amalnathkp13-boop/EquiSense-ForcePlatform/firmware/README.md

# Firmware

ESP32 dual-core firmware (HX711 quad driver, Butterworth filter, CoP and posturography metrics). Scheduled for Month 2 (Dec 2026); see docs/PROJECT_HANDOVER.md, Section 6.
