amalnathkp13-boop/EquiSense-ForcePlatform/hardware/cad/renders/cad_exploded.png

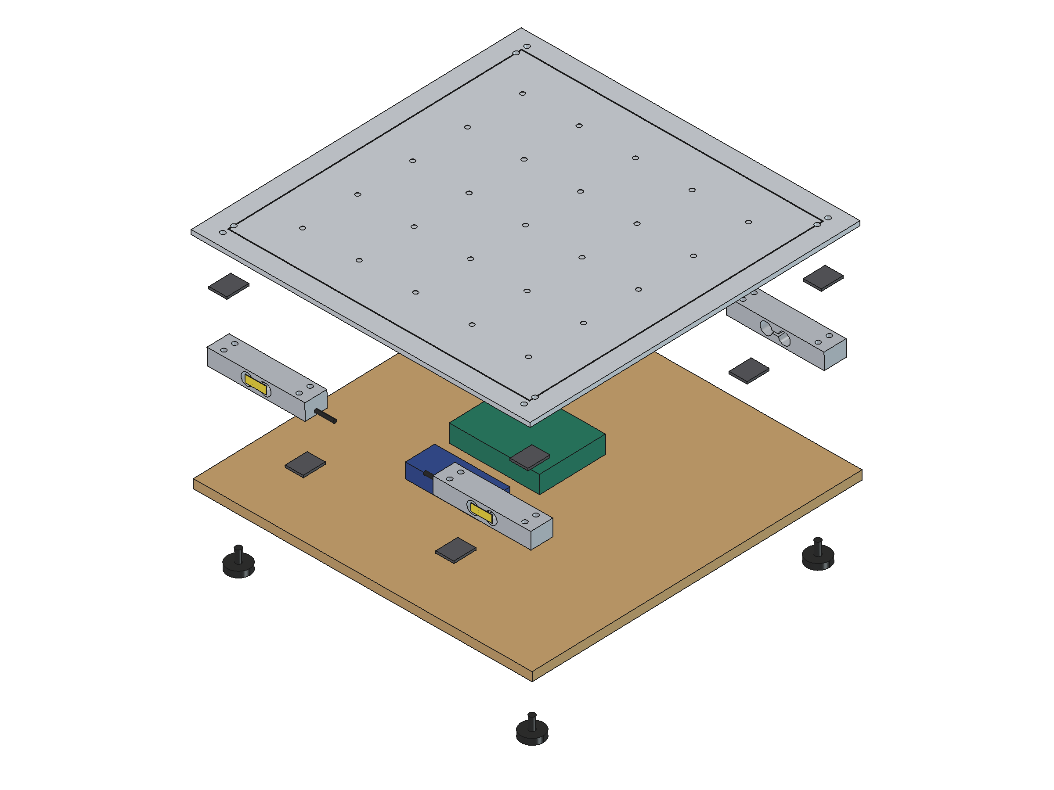
hardware/cad/renders/cad_exploded.png
