amalnathkp13-boop/EquiSense-ForcePlatform/hardware/cad/renders/cad_iso.png

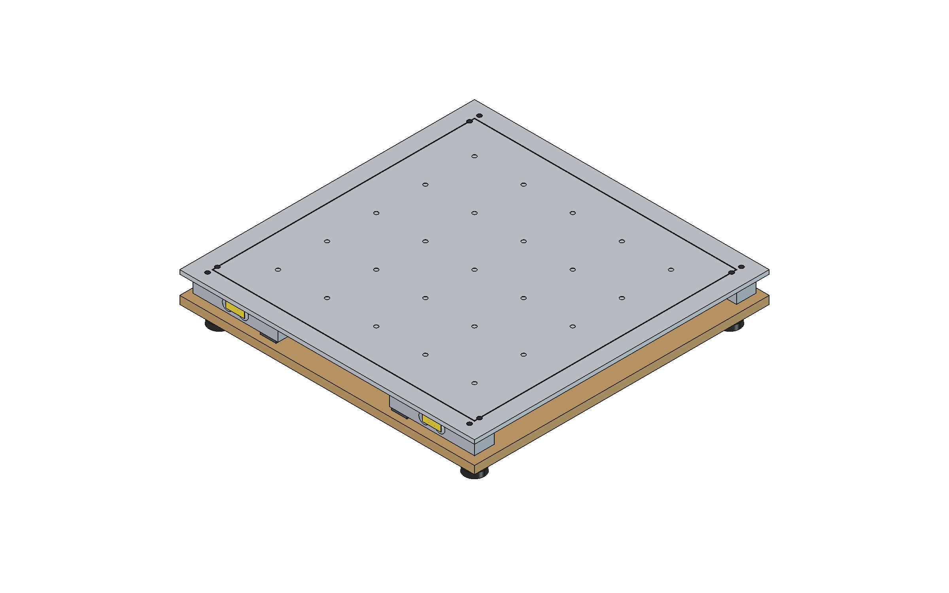
hardware/cad/renders/cad_iso.png
