amalnathkp13-boop/EquiSense-ForcePlatform/hardware/cad/renders/cad_top_xray.png

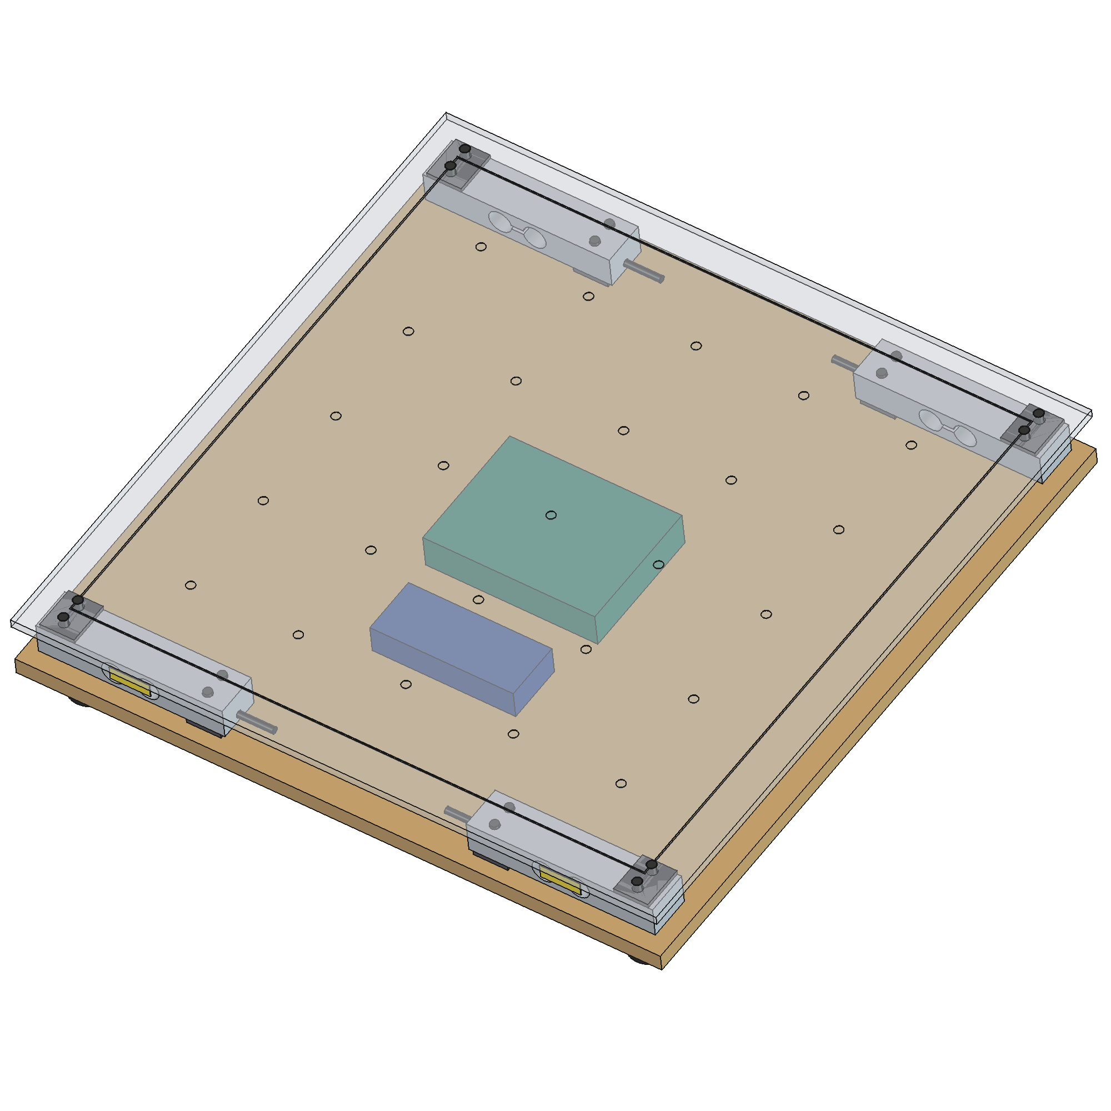
hardware/cad/renders/cad_top_xray.png
