amalnathkp13-boop/EquiSense-ForcePlatform/hardware/cad/renders/fea_vonmises.png

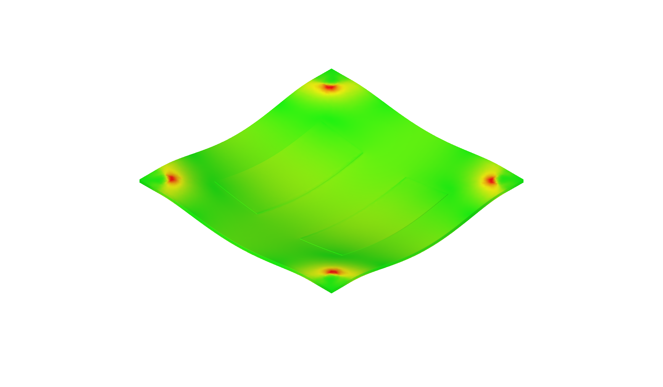
hardware/cad/renders/fea_vonmises.png
