amalnathkp13-boop/EquiSense-ForcePlatform/hardware/kicad/export/EquiSense_BOM.csv

Refs | Value | Footprint | Qty | DNP
C1 | 10uF |  | 1
C2 | 22uF |  | 1
C3 | 1uF |  | 1
C4 | 100nF |  | 1
C10 | 10uF |  | 1
C11 | 100nF |  | 1
C12 | 10uF |  | 1
C13 | 100nF |  | 1
C14 | 10uF |  | 1
C15 | 100nF |  | 1
C16 | 10uF |  | 1
C17 | 100nF |  | 1
D1 | 1N4007 |  | 1
D2 | STATUS |  | 1
J1 | LoadCell_FL |  | 1
J2 | LoadCell_FR |  | 1
J3 | LoadCell_BL |  | 1
J4 | LoadCell_BR |  | 1
J5 | 18650 Shield V8 5V OUT |  | 1
J6 | USB-UART |  | 1
JP1 | HAPTIC_ISOLATE |  | 1
M1 | ERM 10mm 3V |  | 1
Q1 | S8550 |  | 1
Q2 | S8550 |  | 1
Q3 | S8550 |  | 1
Q4 | S8550 |  | 1
Q5 | AO3400A | Package_TO_SOT_SMD:SOT-23 | 1
R1 | 10k |  | 1
R2 | 10k |  | 1
R3 | 1k |  | 1
R4 | 220R |  | 1
R5 | 100k |  | 1
R10 | 20k |  | 1
R11 | 8.2k |  | 1
R12 | 20k |  | 1
R13 | 8.2k |  | 1
R14 | 20k |  | 1
R15 | 8.2k |  | 1
R16 | 20k |  | 1
R17 | 8.2k |  | 1
U1 | ESP32-WROOM-32 | RF_Module:ESP32-WROOM-32 | 1
U2 | AMS1117-3.3 |  | 1
U3 | HX711 | Package_SO:SOIC-16_3.9x9.9mm_P1.27mm | 1
U4 | HX711 | Package_SO:SOIC-16_3.9x9.9mm_P1.27mm | 1
U5 | HX711 | Package_SO:SOIC-16_3.9x9.9mm_P1.27mm | 1
U6 | HX711 | Package_SO:SOIC-16_3.9x9.9mm_P1.27mm | 1
