amalnathkp13-boop/EquiSense-ForcePlatform/hardware/cad/EquiSense_ForcePlatform.step

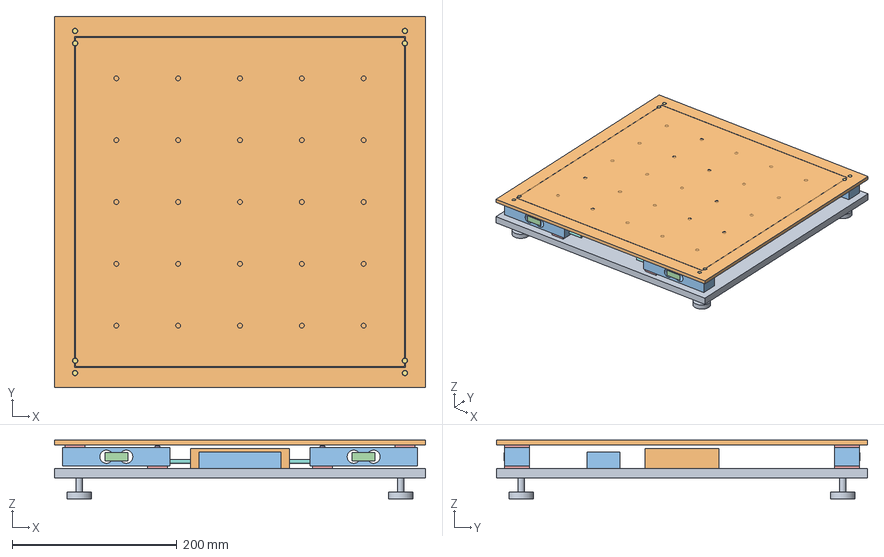
[picture p14: CAD file, 2026-10-14]
hardware/cad/EquiSense_ForcePlatform.step
450.0 x 450.0 x 71.0 mm
