amalnathkp13-boop/EquiSense-ForcePlatform/(list of files, cad)

Other CAD files:
hardware/cad/EquiSense_ForcePlatform.FCStd
