amalnathkp13-boop/EquiSense-ForcePlatform/hardware/kicad/export/EquiSense_schematic.pdf

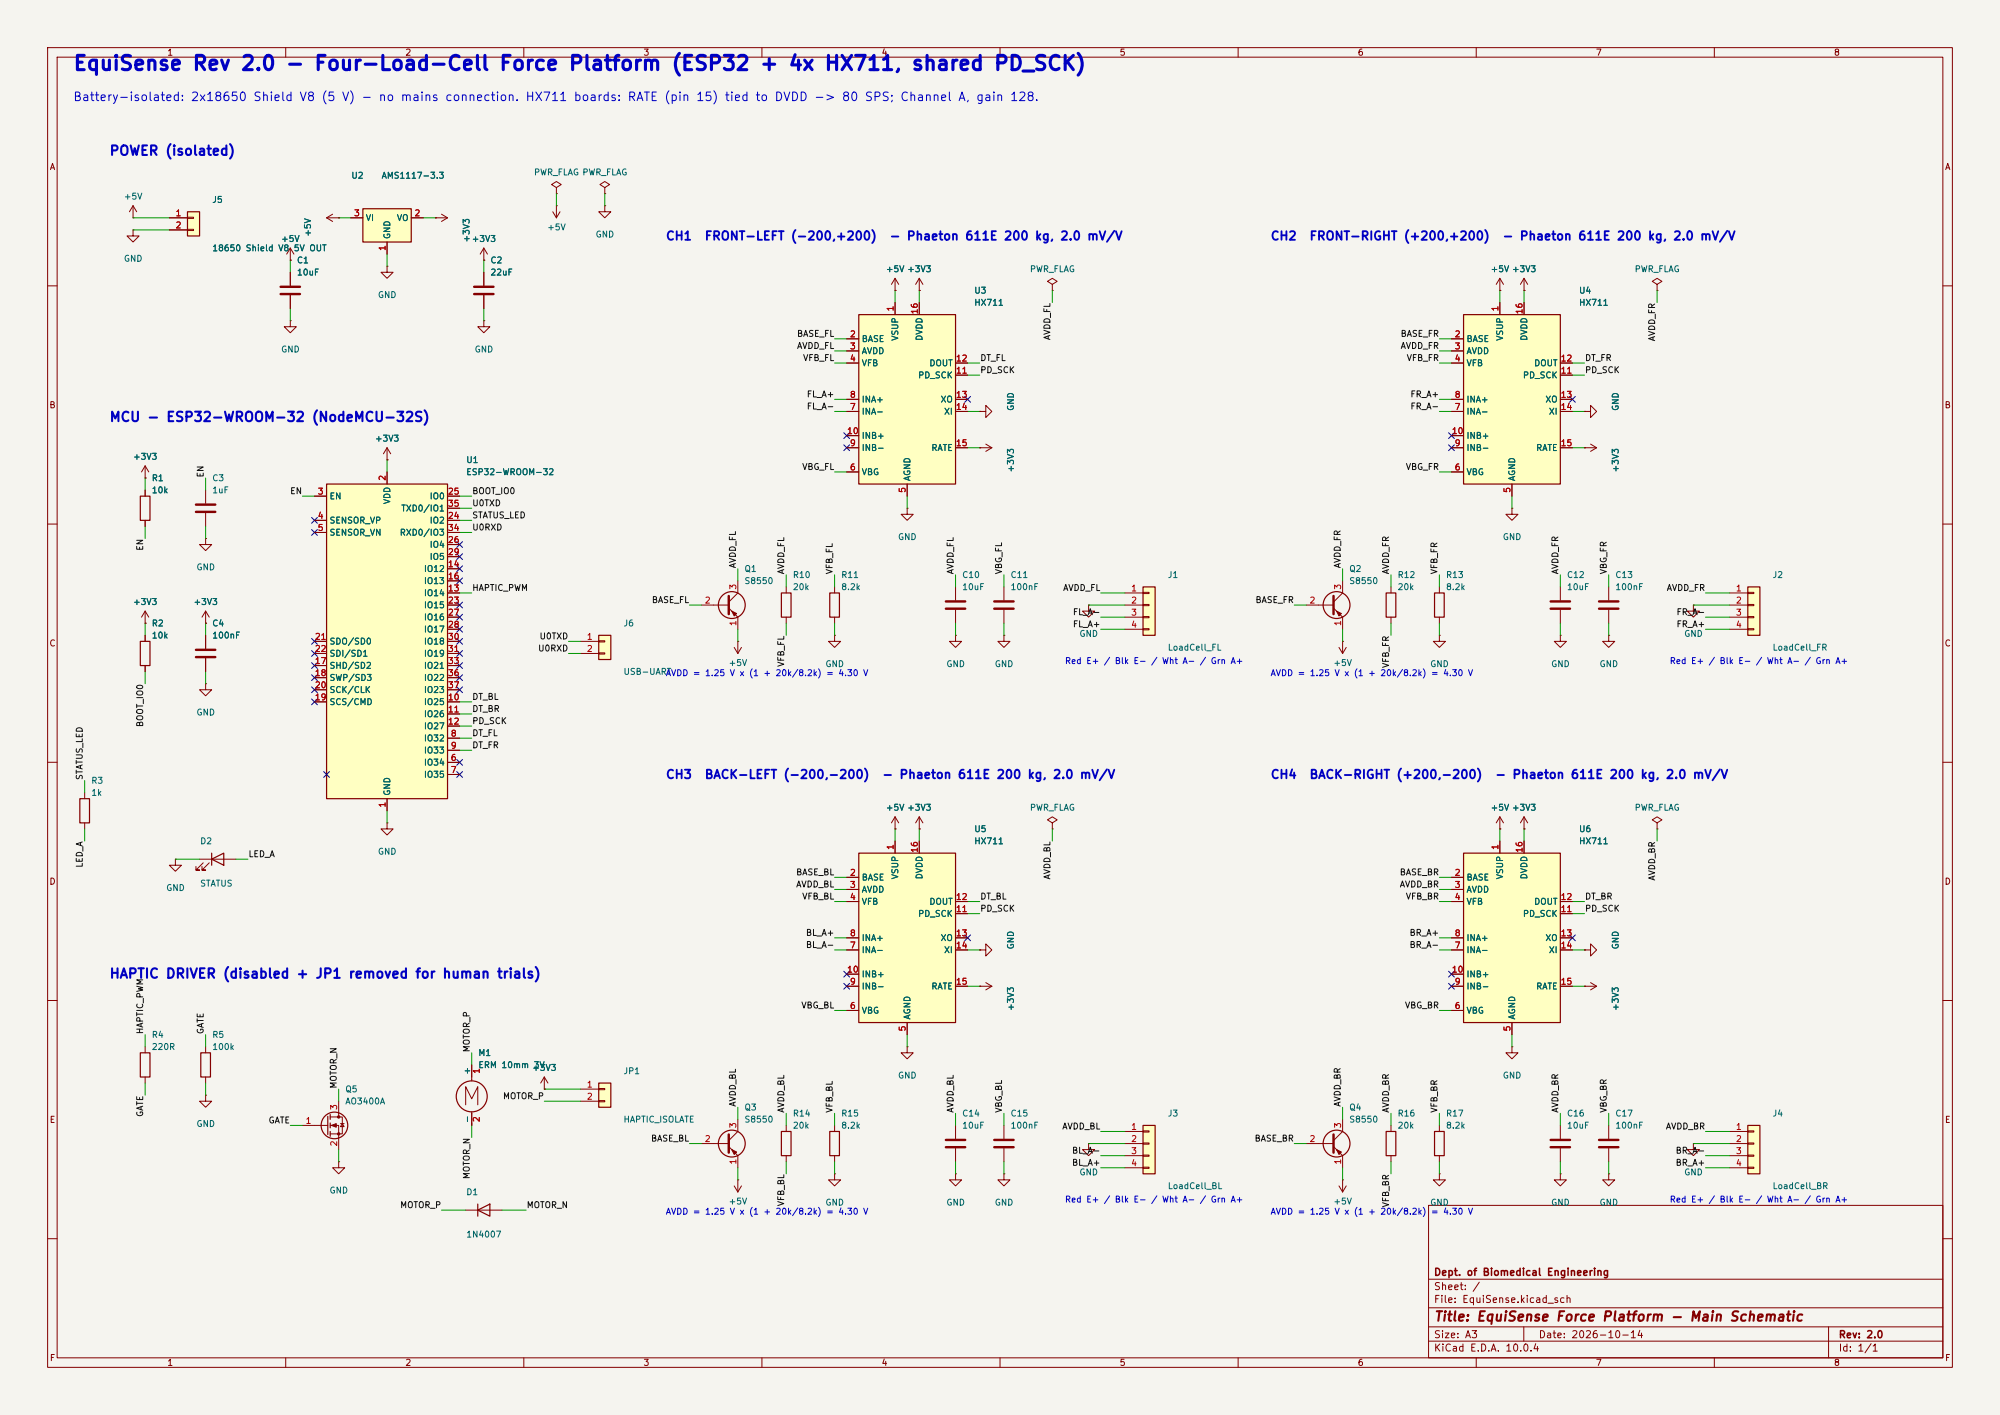
[picture p15: page 1]

EquiSense Rev 2.0 - Four-Load-Cell Force Platform (ESP32 + 4x HX711, shared PD_SCK)

AVDD = 1.25 V x (1 + 20k/8.2k) = 4.30 V Battery-isolated: 2x18650 Shield V8 (5 V) - no mains connection. HX711 boards: RATE (pin 15) tied to DVDD -> 80 SPS; Channel A, gain 128.

Red E+ / Blk E- / Wht A- / Grn A+ CH1 FRONT-LEFT (-200,+200) - Phaeton 611E 200 kg, 2.0 mV/V

AVDD = 1.25 V x (1 + 20k/8.2k) = 4.30 V CH2 FRONT-RIGHT (+200,+200) - Phaeton 611E 200 kg, 2.0 mV/V

Red E+ / Blk E- / Wht A- / Grn A+

Red E+ / Blk E- / Wht A- / Grn A+ CH3 BACK-LEFT (-200,-200) - Phaeton 611E 200 kg, 2.0 mV/V

HAPTIC DRIVER (disabled + JP1 removed for human trials)

Dept. of Biomedical Engineering
Sheet: /
File: EquiSense.kicad_sch
Title: EquiSense Force Platform - Main Schematic

Size: A3 | Rev: 2.0 | F Date: 2026-10-14
KiCad E.D.A. 10.0.4 | Id: 1/1
