amalnathkp13-boop/EquiSense-ForcePlatform/hardware/kicad/EquiSense.kicad_sch

## KiCad design hardware/kicad/EquiSense.kicad_sch (2026-10-14)

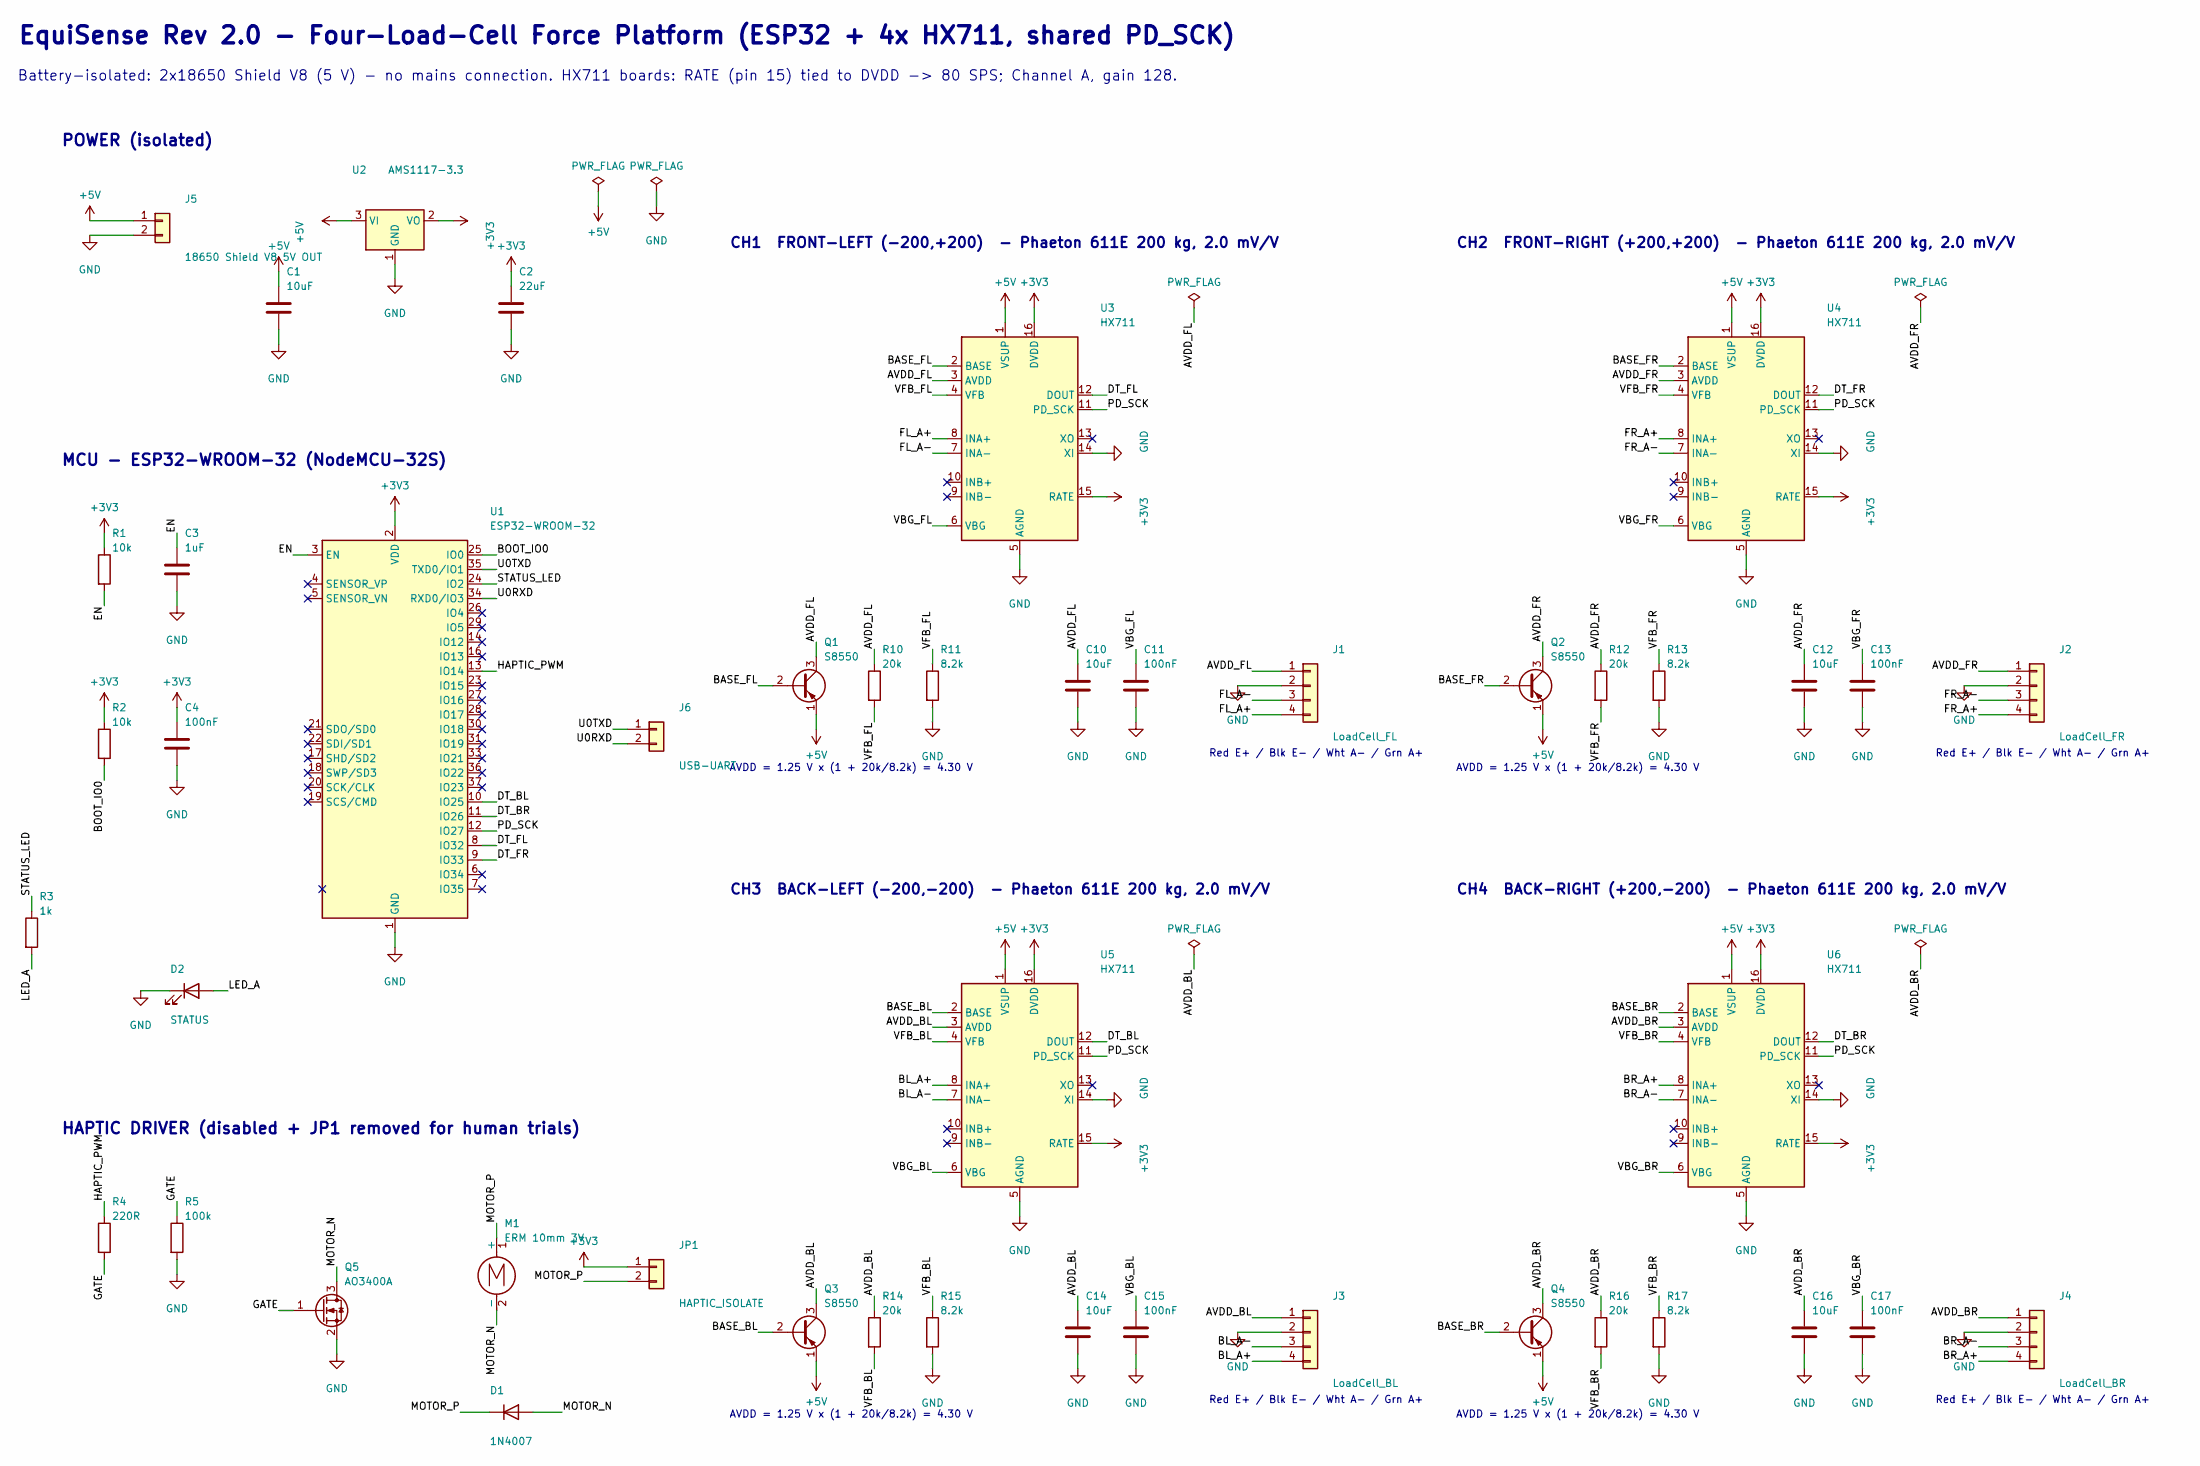
[picture p16: schematic EquiSense.kicad_sch]

Parts:
C1, C10, C12, C14, C16: 10uF
C2: 22uF
C3: 1uF
C4, C11, C13, C15, C17: 100nF
D1: 1N4007
D2: STATUS
J1: LoadCell_FL
J2: LoadCell_FR
J3: LoadCell_BL
J4: LoadCell_BR
J5: 18650 Shield V8 5V OUT
J6: USB-UART
JP1: HAPTIC_ISOLATE
M1: ERM 10mm 3V
Q1, Q2, Q3, Q4: S8550
Q5: AO3400A; SOT-23
R1, R2: 10k
R3: 1k
R4: 220R
R5: 100k
R10, R12, R14, R16: 20k
R11, R13, R15, R17: 8.2k
U1: ESP32-WROOM-32
U2: AMS1117-3.3
U3, U4, U5, U6: HX711; SOIC-16_3.9x9.9mm_P1.27mm

Connections:
+3V3: C2.1, C4.1, JP1.1, R1.1, R2.1, U1.2 (VDD), U2.2 (VO), U3.15 (RATE), U3.16 (DVDD), U4.15 (RATE), U4.16 (DVDD), U5.15 (RATE), U5.16 (DVDD), U6.15 (RATE), U6.16 (DVDD)
+5V: C1.1, J5.1, Q1.1 (E), Q2.1 (E), Q3.1 (E), Q4.1 (E), U2.3 (VI), U3.1 (VSUP), U4.1 (VSUP), U5.1 (VSUP), U6.1 (VSUP)
AVDD_BL: C14.1, J3.1, Q3.3 (C), R14.1, U5.3 (AVDD)
AVDD_BR: C16.1, J4.1, Q4.3 (C), R16.1, U6.3 (AVDD)
AVDD_FL: C10.1, J1.1, Q1.3 (C), R10.1, U3.3 (AVDD)
AVDD_FR: C12.1, J2.1, Q2.3 (C), R12.1, U4.3 (AVDD)
BASE_BL: Q3.2 (B), U5.2 (BASE)
BASE_BR: Q4.2 (B), U6.2 (BASE)
BASE_FL: Q1.2 (B), U3.2 (BASE)
BASE_FR: Q2.2 (B), U4.2 (BASE)
BL_A+: J3.4, U5.8 (INA+)
BL_A-: J3.3, U5.7 (INA-)
BOOT_IO0: R2.2, U1.25 (IO0)
BR_A+: J4.4, U6.8 (INA+)
BR_A-: J4.3, U6.7 (INA-)
DT_BL: U1.10 (IO25), U5.12 (DOUT)
DT_BR: U1.11 (IO26), U6.12 (DOUT)
DT_FL: U1.8 (IO32), U3.12 (DOUT)
DT_FR: U1.9 (IO33), U4.12 (DOUT)
EN: C3.1, R1.2, U1.3 (EN)
FL_A+: J1.4, U3.8 (INA+)
FL_A-: J1.3, U3.7 (INA-)
FR_A+: J2.4, U4.8 (INA+)
FR_A-: J2.3, U4.7 (INA-)
GATE: Q5.1 (G), R4.2, R5.1
GND: C1.2, C2.2, C3.2, C4.2, C10.2, C11.2, C12.2, C13.2, C14.2, C15.2, C16.2, C17.2, D2.1 (K), J1.2, J2.2, J3.2, J4.2, J5.2, Q5.2 (S), R5.2, R11.2, R13.2, R15.2, R17.2, U1.1 (GND), U1.15 (GND), U1.38 (GND), U1.39 (GND), U2.1 (GND), U3.5 (AGND), U3.14 (XI), U4.5 (AGND), U4.14 (XI), U5.5 (AGND), U5.14 (XI), U6.5 (AGND), U6.14 (XI)
HAPTIC_PWM: R4.1, U1.13 (IO14)
LED_A: D2.2 (A), R3.2
MOTOR_N: D1.2 (A), M1.2 (-), Q5.3 (D)
MOTOR_P: D1.1 (K), JP1.2, M1.1 (+)
PD_SCK: U1.12 (IO27), U3.11 (PD_SCK), U4.11 (PD_SCK), U5.11 (PD_SCK), U6.11 (PD_SCK)
STATUS_LED: R3.1, U1.24 (IO2)
U0RXD: J6.2, U1.34 (RXD0/IO3)
U0TXD: J6.1, U1.35 (TXD0/IO1)
VBG_BL: C15.1, U5.6 (VBG)
VBG_BR: C17.1, U6.6 (VBG)
VBG_FL: C11.1, U3.6 (VBG)
VBG_FR: C13.1, U4.6 (VBG)
VFB_BL: R14.2, R15.1, U5.4 (VFB)
VFB_BR: R16.2, R17.1, U6.4 (VFB)
VFB_FL: R10.2, R11.1, U3.4 (VFB)
VFB_FR: R12.2, R13.1, U4.4 (VFB)

Notes on the sheet:
EquiSense Rev 2.0 - Four-Load-Cell Force Platform (ESP32 + 4x HX711, shared PD_SCK)
Battery-isolated: 2x18650 Shield V8 (5 V) - no mains connection. HX711 boards: RATE (pin 15) tied to DVDD -> 80 SPS; Channel A, gain 128.
POWER (isolated)
MCU - ESP32-WROOM-32 (NodeMCU-32S)
HAPTIC DRIVER (disabled + JP1 removed for human trials)
CH1 FRONT-LEFT (-200,+200) - Phaeton 611E 200 kg, 2.0 mV/V
Red E+ / Blk E- / Wht A- / Grn A+
AVDD = 1.25 V x (1 + 20k/8.2k) = 4.30 V
CH2 FRONT-RIGHT (+200,+200) - Phaeton 611E 200 kg, 2.0 mV/V
CH3 BACK-LEFT (-200,-200) - Phaeton 611E 200 kg, 2.0 mV/V
CH4 BACK-RIGHT (+200,-200) - Phaeton 611E 200 kg, 2.0 mV/V
