amalnathkp13-boop/EquiSense-ForcePlatform/(commit log)

2026-10-14 EquiSense Rev 2.0: CAD assembly, top-plate FEA, KiCad schematic, BOM and Stage 2 documentation
    [BOM.csv, EquiSense.kicad_pcb, EquiSense.kicad_sch, EquiSense_BOM.csv, EquiSense_ForcePlatform.FCStd, EquiSense_ForcePlatform.step, fea_6mm_nodes.csv]
2026-10-14 Stage 2 deck: expand to the full 20-slide Vishwakarma template
